m4REK/Projekt-B/Projekt B_Dokumentation.pdf

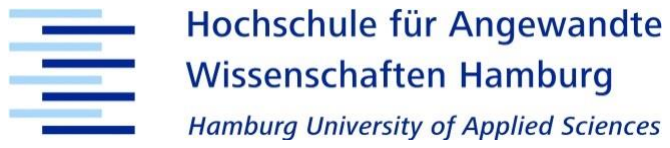
[picture p1: figure]

Fakultät Design, Medien, Information

Kunst- und Mediencampus Hamburg

Department Medientechnik

Studiengang Media Systems

Projekt:

## Arduino-Smart-Home

„Entwicklung und Konstruktion einer Steuerung für Funksteckdosen via Web-App“

Projektteilnehmer: Marko Vukadinovic, Sebastian Bohn, Johannes Bagge, Florian Langhorst

Projektleiter: Prof. Dr. Andreas Plaß, Dipl. Ing. Michael Berens

Projekt B | Arduino-Smart-Home

## Inhaltsverzeichnis

## 1 Projektbeschreibung

Das Ziel dieses Projekts ist es mit Hilfe einer Arduino Uno Entwicklungsplattform und einer

selbstentwickelten Webseite, eine oder mehrere Funksteckdosen ein- und ausschalten zu

können. Erweitert wird dies um eine Steuerung für den Betrieb einer

Pflanzenbewässerungsanlage.

## 2 Projektplanung

### 2.1 Definition der Projektumsetzung

Eine möglichst genaue Definition der zu realisierenden Ziele ist wichtig, um das Projekt

effektiv umzusetzen. Folgende Meilensteine wurden in der Planung definiert:

- Netzwerkkommunikation durch den Arduino
- Steuerung der Stromquellen durch den Arduino
- Webinterface für kabellose Kommunikation
- Ansteuern einer Pflanzenbewässerung

Vorab ist es ratsam sich im Internet über ähnliche Projekte zu informieren, um eine Liste der

benötigten Komponenten zu erstellen. Von Vorteil sind Grundkenntnisse der Elektrotechnik,

Elektronik, Netzwerktechnik und objektorientierten Programmierung. Es sollte auch

genügend Zeit für Testphasen eingeplant werden, um sich den sicheren Umgang mit den

einzelnen Elementen anzueignen. Eine gute Quelle für den Einstieg ist die Webseite

http://www.arduino.cc, auf der viele nützliche Tutorials und ein hilfreiches Forum zu finden

sind.

## 3 Hardware

### 3.1 Arduino Uno R3

Arduino Uno R3 ist ein Mikrocontroller Entwicklungsboard das auf dem ATmega328 basiert.

Dieser wird für sogenanntes „Prototyping“ genutzt, um zum Beispiel den Input von

verschiedenen Sensoren und Schaltern zu verarbeiten und über den Output Stromkreise,

Lichtquellen, Relais und Motoren zu kontrollieren.

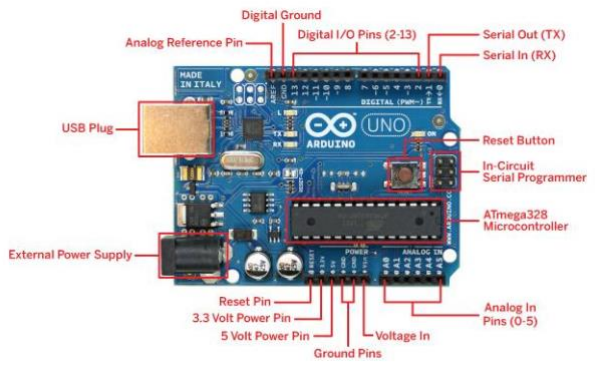
[picture p2: figure]

Datenblatt Arduino Uno R3
Mikrocontroller | ATmega328
Betriebsspannung | 5V
Eingangsspannung (empfohlen) | 7-12V
Eingangsspannung
(maximum) | 6-20V
Digitale I/O Pins | 14 (6 bieten PWM/Pulse-width modulation)
Analoge Input Pins | 6
DC pro I/O Pin | 40 mA
DC für 3.3V Pin | 50 mA
Flash Speicher | 32 KB (ATmega328), davon 0.5 KB für den
| Bootloader belegt
SRAM | 2 KB (ATmega328)
EEPROM | 1 KB (ATmega328)

Abbildung 1: Arduino Uno R3 und Erläuterung der Elemente

Clock Frequenz | 16 MHz
Kosten | ca. 22,00 €

### 3.2 Ethernet-Shield

Ein Shield ist eine Erweiterung des Boards, welches zusätzliche Schnittstellen für den

Mikrocontroller bietet. Mit dem Ethernet-Shield ist es möglich durch ein RJ45 LAN-Kabel

eine Netzwerkverbindung aufzubauen. Zusätzlich bietet dieser noch einen Steckplatz für

eine Mikro-SD Karte zur Auslagerung größerer Daten. Der Shield wird direkt auf den Arduino

aufgesteckt, so dass die Pins über das Shield zu erreichen sind. Jedoch werden für die einige

Funktionen mehrere Pins belegt. Zu Beginn wurde ein Nachbau des Originals verwendet,

welches jedoch Probleme mit der Stabilität der Stromversorgung bereitete. Daraufhin wurde

ein Original Arduino Ethernet-Shield nachgekauft und verwendet.

Datenblatt Arduino Ethernet-Shield
Betriebsspannung | 5V (über den Arduino)
Ethernet Controller | W5100 mit internem 16K Buffer
Verbindungsgeschwindigkeit | 10/100 Mb
Pin 4 | Mikro-SD Kartenslot
Pin 10-13 | W5100 und Netzwerkkommunikation
Bibliotheken | Ethernet.h; SD.h; SPI.h;...usw.
LEDs
PWR | Stromversorgung aktiv
LINK | leuchtet bei vorhandener
| Netzwerkverbindung; blinkt wenn das Shield
| Daten sendet oder empfängt
100M | bei einer 100 Mb/s Verbindung
RX | Daten werden empfangen
TX | Daten werden gesendet
FULLD | Netzwerkverbindung ist Vollduplex
COLL | blinkt bei Netzwerkkollisionen
Kosten Nachbau | ca. 8,00 €
Kosten Original | ca. 30,00 €

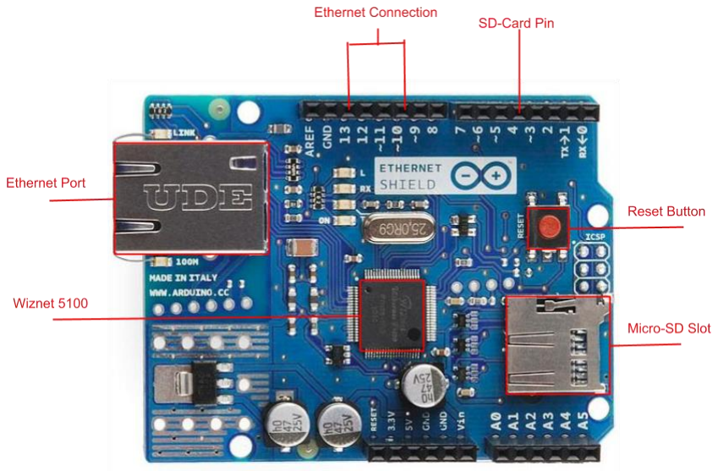
[picture p3: figure]

Abbildung 2 : Arduino Ethernet-Shield mit Erläuterung der Elemente

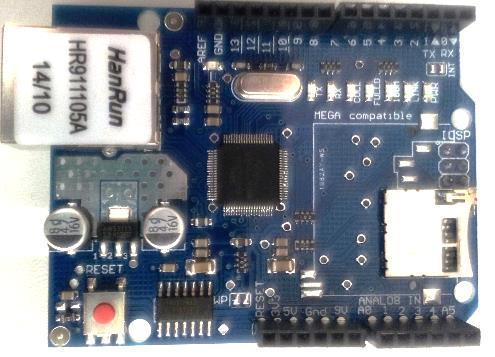
[picture p4: figure]

Abbildung 3: Ethernet-Shield Nachbau

### 3.3 Relais

Ein Relais ist ein durch elektrischen Strom betriebener Schalter, mit dem man andere

Stromkreise aktivieren oder deaktivieren kann. Für dieses Projekt wurden zwei 4-Kanal

Relais verwendet, welche einen Default-Zustand auf HIGH haben und auf LOW schalten.

Datenblatt Relais
Betriebsspannung über Arduino | 5V
Strom pro Kanal | 15 - 20mA

VCC | Integrated Circuit (IC) Stromversorgung
| (positiv)
GND | Ground
IN1-IN4 | Relais 1-4; je eine Verbindung zu einem I/O
| Pin
NC | Normally Closed; Ruhekontakt; Break
NO | Normally Open; Arbeitskontakt; Make
CO | Change Over; Wechselkontakt; Break-Make
Kosten pro Modul | ca 3,60 €

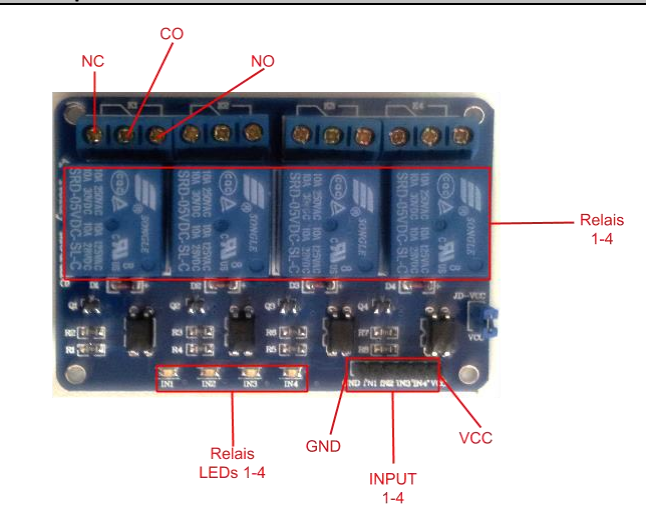
[picture p5: figure]

Abbildung 4: 5V 4-Kanal Relais mit Erläuterung der Elemente

### 3.4 Funksteckdosen mit Sender

Verwendet wurden handelsübliche 433 MHz Funksteckdosen mit vier Kanälen an der

Fernbedienung und drei Steckdosen (ohne Dip Schalter). Der Aufbau der Platine der

Fernbedienung unterscheidet sich je nach Hersteller.

Datenblatt Funksteckdosen-Set
Betriebsspannung Fernbedienung | 12V Batterie
Spannung Steckdosen | 230V / 50 Hz
maximale Schaltleistung | 1000 W
Reichweite | ca. 30 m
Frequenz | 433.92 MHz
Verwendetes Modell | Mumbi m-FS300

Kosten | ca. 17,00 €

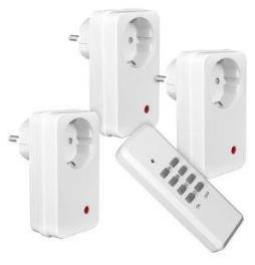
[picture p6: figure]

Abbildung 5: Funksteckdosen-Set von Mumbi

### 3.5 Verbrauchsmaterial, Kabel und Zusatzteile

- Schrumpfschlauch
- Lötplatinen
- Schrauben und Muttern
- Abstandshalter
- Jumper Kabel
- Kabel-Steckbrücken
- 8-poliges RJ-45 Netzwerkkabel
- 9V Netzteil
- Breadboard, LEDs, Widerstände (für Testaufbauten)

### 3.6 Werkzeug

- Schraubendreher
- Crimpzange
- Multimeter

- Heißklebepistole und Kleber
- Bohrmaschine

## 4 Software

Arduino bietet eine eigene, auf Java basierende, Open-Source Entwicklungsumgebung,

welche vorab schon viele Bibliotheken und Beispielprogramme enthält. Als

Programmiersprache wird Processing verwendet, welche an eine vereinfachte Variante von

C++ erinnert und objektorientiert ist.

Mit der Entwicklungsumgebung können Programme geschrieben, getestet, auf den

Mikrocontroller aufgespielt und während der Laufzeit debugged werden. Diese läuft auf

allen üblichen Systemen wie Windows, Mac OS X und Linux.

http://arduino.cc/en/Main/Software

## 5 Umsetzung

### 5.1 Analyse und Tests der Bauteile

Im ersten Schritt der Projektrealisierung, ist es von Vorteil sich mit den einzelnen

Komponenten und ihren Funktionen vertraut zu machen. Zum Einstieg kann man sich mit

einfachen Versuchsaufbauten einarbeiten. Hier können die verschiedenen Basic-

Beispielprogramme der Entwicklungsumgebung helfen. Ein Beispielaufbau wäre, eine

einfache LED über den Arduino und ein Relais zum leuchten zu bringen. Dafür ist es nötig

sich mit grundlegenden Regeln der Elektrotechnik auseinanderzusetzen, wie Stromstärke,

Spannung, Widerständen und Flussrichtung. Das Programm oder Sketch wie es in der

Entwicklungsumgebung heißt, bestimmt die Pins (Aus-/Eingänge) und was dort passieren

soll. Dieser kann aus einem oder mehreren Tabs bestehen, wodurch objektorientierter Code

möglich ist. Dieser darf beim Uno jedoch maximal 32 KB groß sein. Wenn das Programm erfolgreich auf den Arduino geladen wurde, läuft dieses in einer Endlosschleife, solange die

Stromzufuhr aktiv ist. Die Kabelverbindungen können alle mit simplen Jumper Wires

(Kabelbrücken) verdrahtet werden. Bei den Tests der Relais, kann es sein das die

Stromzufuhr über das USB-Kabel des Computers nicht ausreicht und ein instabiles oder gar

kein Signal bei den Relais ankommt. Hierfür ist ein zusätzliches Netzteil von Vorteil.

Der nächste Schritt ist die Analyse der Funkfernbedienung des Steckdosen-Sets. Diese

können je nach Hersteller variieren. In diesem Fall besteht die Platine aus acht

Kontaktpunkten (vier ON; vier OFF), drei Kontaktbrücken, in denen bestimmte Kontakte

zusammenlaufen, und einem Logik-Gatter. Die acht Kontaktpunkte sind jeweils gespalten

und das Auslösen des jeweiligen Funksignals erfolgt durch Überbrückung des Kontakts. Nun

testet man, welche Kombinationen aus Punkten und Brücken welches Signal auslösen und

schreibt das Ergebnis in eine Tabelle. Aus dieser Tabelle ermittelt man die kleinstmögliche

Anzahl der benötigten Lötpunkte.

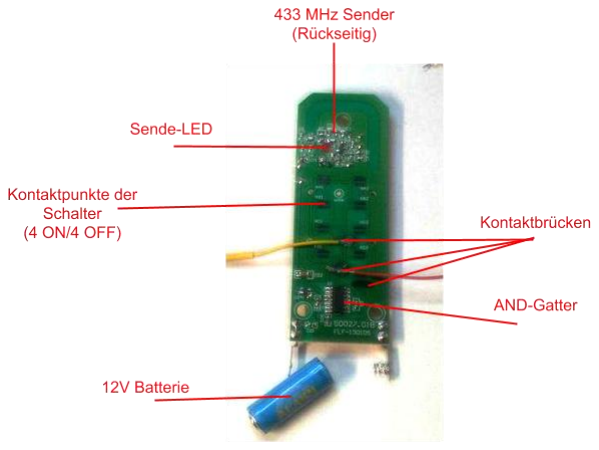
[picture p7: figure]

Abbildung 6: Platine der Funkfernbedienung und Erläuterung der Elemente

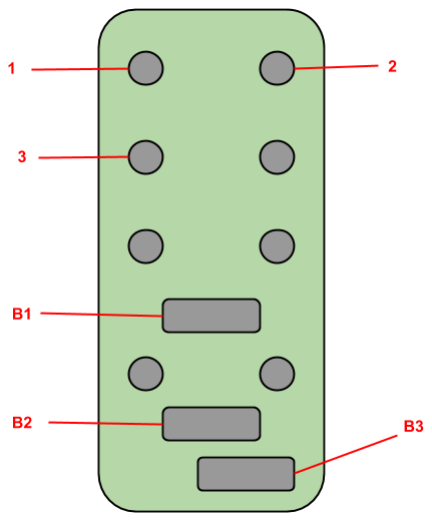
[picture p8: figure]

Abbildung 7: Deklaration der gewählten Kontakte

Schalter | AND-Verknüpfung von Kontakt A und Kontakt B
A ON | 2 | 1
A OFF | 2 | B3
B ON | 2 | 3
B OFF | 2 | B2
C ON | B1 | 1
C OFF | B1 | B3
D ON | B1 | 3
DOFF | B1 | B2

### 5.2 Verkabelung der Sende-Platine

Für das verkabeln der gewählten Punkte ist löten leider nicht immer möglich, da Lötzinn auf

dieser Art Platinen nicht haftet. Eine Alternative ist Heißkleber, welcher nach anpressen

genügend halt gibt, aber sich auch rückstandsfrei lösen lässt.

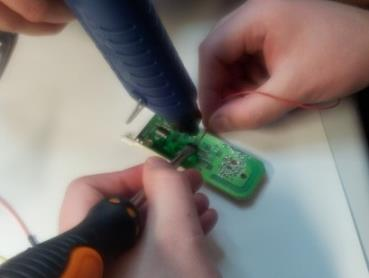
[picture p9: figure]

Abbildung 8: Verbindung der Kabel mit Heißkleber auf den Kontakten

Mit Hilfe der erstellten Schalttabelle, können die minimal benötigten Kontaktpunkte

ermittelt werden und entsprechend viele Abzweigungen des Kabels vorgenommen werden.

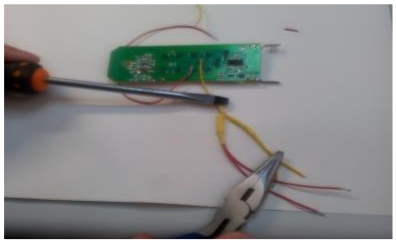
[picture p10: figure]

Abbildung 9: Verzweigungen der Kabel für einzelne Kontakte

Farbige Kabel können zur Übersicht beitragen. Um die Abzweigungen zu isolieren und

festigen, sollte Schrumpfschlauch verwendet werden.

Um die Platine und die Klebepunkte vor äußeren Einwirkungen zu schützen, kann die

Plastikhülle weitervervendet werden. Dabei reicht ein seitlich eingefräster Schlitz als

Durchlass und Zugentlasstung.

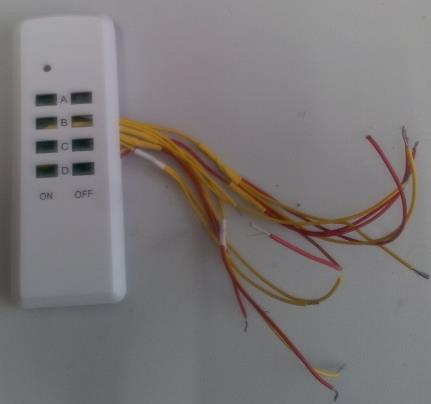
[picture p11: figure]

Abbildung 10: Funkfernbedienung mit fertiger Verkabelung

### 5.3 Verbindung von Arduino, Relais und Sender

Als nächstes wird das Auslösen eines Funksignals über ein Relais getestet. Ein kurzer Impuls

reicht dem Schalter in der Regel aus. Dieser liegt in etwa bei 500 ms, da bei zu kurzen

Impulsen der Empfänger nicht immer ein Signal empfängt. Ein Pin ist mit einem Relais, für

einen Schalter zuständig.

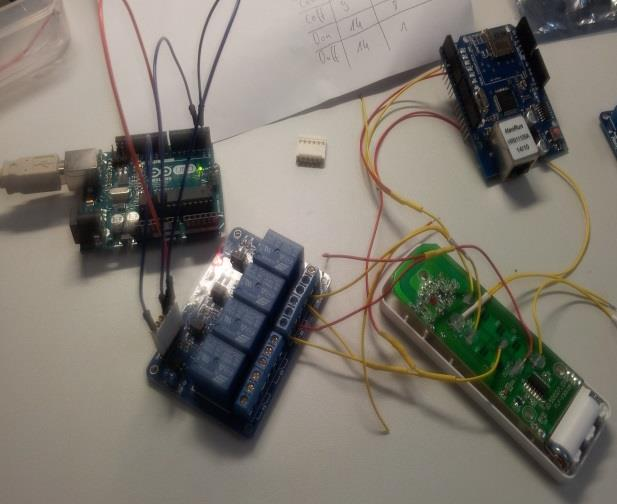
[picture p12: figure]

Abbildung 11: Testen der Steuerung des Senders über den Arduino und Relais

Um alle Schalter anzusteuern, benötigt man also acht freie I/O Pins und acht Relais. Da in

einem Set aber nur drei Steckdosen enthalten sind, reichen sechs Pins und Relais aus.

Entsprechend kann man einen ON und zugehörigen OFF Schalter frei lassen und diesen

isolieren. Es sollte ebenfalls bedacht werden, das Pin 10 – 13 für den Ethernet-Shield und Pin

4 für die Mikro-SD Karte (wenn benötigt) reserviert sind. Um beide Relais-Module zu nutzen,

muss vom Arduino ausgehend eine Parallelschaltung zu den beiden Relais gelegt werden.

Dies erreicht man mit der Splittung des 5V und GND Aus-/Eingangs. Unterstützend ist hier

ein Netzteil anzuraten, um die Stromzufuhr der Relais zu stabilisieren.

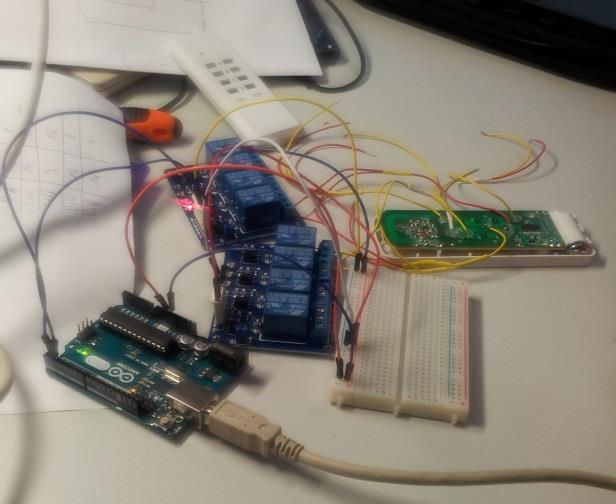
[picture p13: figure]

Abbildung 12: Test mit beiden Relais-Modulen

Wenn alle Relais zufriedenstellend schalten, kann die Anordnung der Bauteile für eine

kompakte Fixierung geplant werden. Um die Kabelwege nicht unnötig lang zu gestalten und

die Fläche klein zu halten, empfiehlt es sich auf zwei oder mehreren Ebenen zu arbeiten.

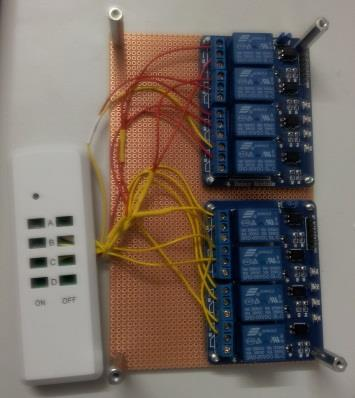
[picture p14: figure]

Abbildung 13: Relais auf einer Lötplatte

In diesem Beispiel werden zwei Ebenen verwendet. Als Platte können Leiterplatinen dienen,

welche durch aufgebohrte Löcher verschraubt werden. Auf der unteren Platine sind die

beiden Relais-Module und die Fernbedienung angeordnet. Das Batteriefach der

Fernbedienung sollte allerdings noch einfach zu erreichen sein.

Auf der oberen Platine sind Arduino Uno und Ethernet-Shield aufeinander gesteckt und

verschraubt. Die Position sollte auch idealerweise am Rand der Platine, mit den Anschlüssen

für Ethernet, Strom und USB nach außen sein. Das ermöglicht den vereinfachten Zugang der

Anschlüsse, falls die Konstruktion in eine Box gesetzt werden soll.

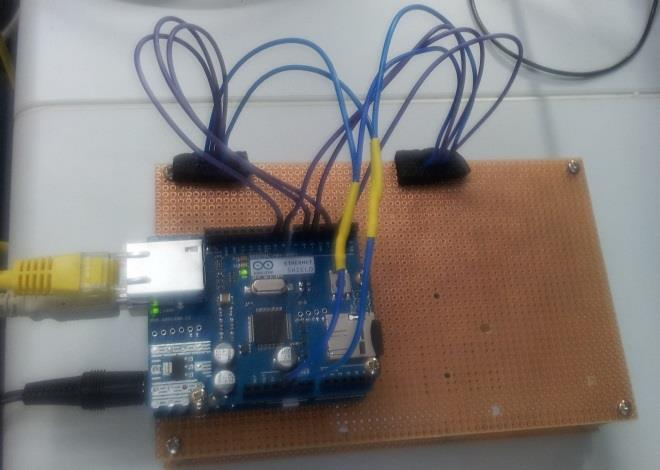
[picture p15: figure]

Abbildung 14: Oberer Teil des Zusammenbaus mit Arduino und Shield

## 6 Programmierung

Das Programm mit dem Webserver, den Webseiten und der Pin-Steuerung besteht aus einer

Klasse.

Einbinden der benötigten Bibliotheken, die der Shield-

Erweiterung und der Netzwerkkommunikation.

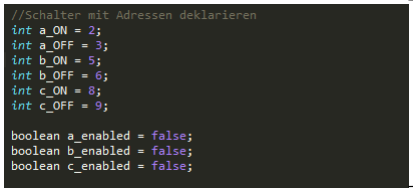
[picture p16: figure]

Setzen der Variablen, welche mit den

gewählten Pins übereinstimmen müssen.

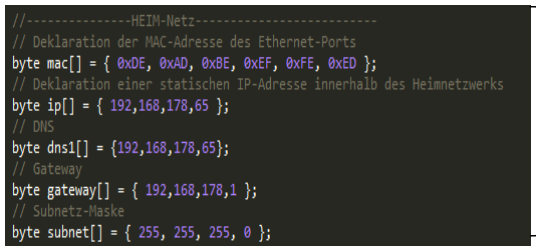
[picture p17: figure]

Deklaration einer statischen,

selbstgewählten MAC-Adresse. IP-Adresse,

DNS, Gateway und Subnetz muss nur selbst

vergeben werden wenn DHCP nicht

genutzt wird.

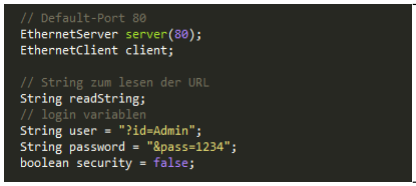
[picture p18: figure]

Variablen für den Server, das Speichern der

Zeichen in der URL, sowie für den Login

(hier inkl. Präfixe) werden deklariert.

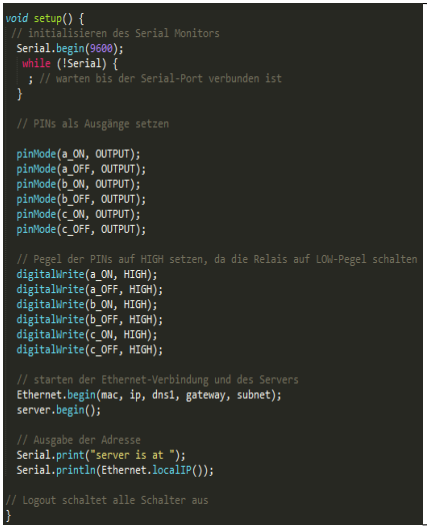
[picture p19: figure]

Die „setup()“-Methode wartet

zunächst solange bis der Serial-Port

verbunden ist.

Danach werden die Pins für die drei

Funksteckdosen als Ausgänge

festgelegt und ihre Pegel

standardmäßig auf High gesetzt.

Nun werden die Ethernetverbindung

und der Server gestartet. Die Adresse

wird im Serial Monitor ausgegeben.

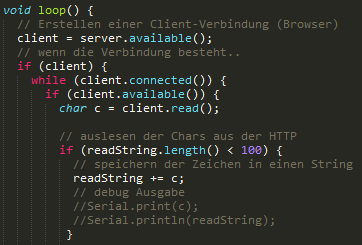
[picture p20: figure]

In der loop()-Methode wird zunächst eine

Clientverbindung (Browser) aufgebaut, welche so

lange wartet, bis ein Client verbunden ist.

Danach werden die Zeichen aus der URL

ausgelesen und in einer String-Variablen

gespeichert.

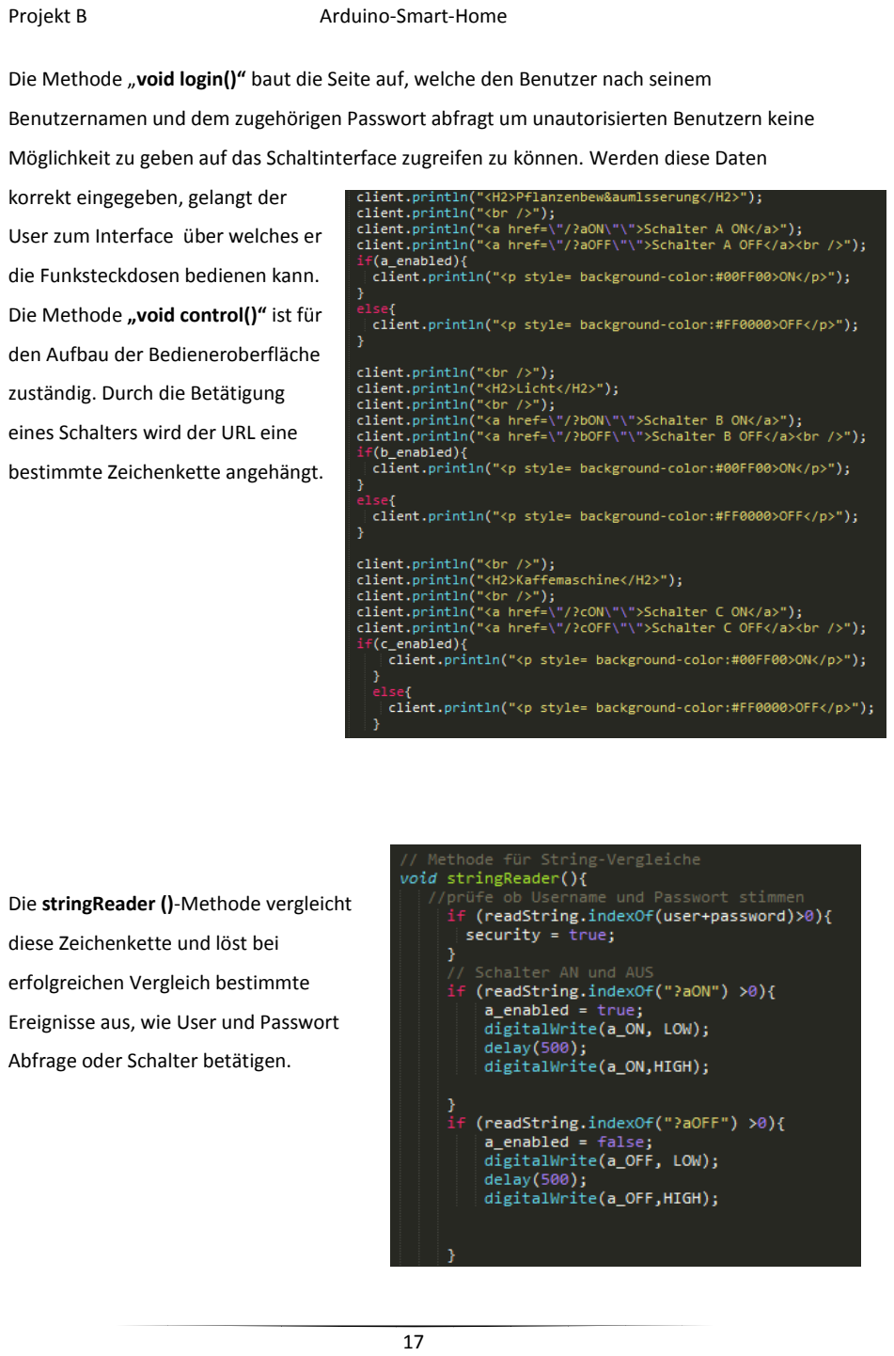
[picture p21: page 18]

Die Methode „void login()“ baut die Seite auf, welche den Benutzer nach seinem

Benutzernamen und dem zugehörigen Passwort abfragt um unautorisierten Benutzern keine

Möglichkeit zu geben auf das Schaltinterface zugreifen zu können. Werden diese Daten

korrekt eingegeben, gelangt der

User zum Interface über welches er

die Funksteckdosen bedienen kann.

Die Methode „void control()“ ist für

den Aufbau der Bedieneroberfläche

zuständig. Durch die Betätigung

eines Schalters wird der URL eine

bestimmte Zeichenkette angehängt.

Die stringReader ()-Methode vergleicht

diese Zeichenkette und löst bei

erfolgreichen Vergleich bestimmte

Ereignisse aus, wie User und Passwort

Abfrage oder Schalter betätigen.

## 7 Programmierung der Steckdosen

Um den Funksteckdosen einen bestimmten Kanal/Schalter zuzuweisen, muss man

entsprechend vorgehen:

1. Eine einzelne Steckdose einstecken.
2. Einen Schalter im Interface anklicken.
3. Steckdose ist nun über diesen Schalter anwählbar.

Für die übrigen Steckdosen Schritte 1. – 3. wiederholen.

Um den Kanal/Schalter einer Funksteckdose wieder zu löschen, muss man entsprechend

vorgehen:

1. Falls die gewählte Steckdose aktiviert ist, diese ausschalten.
2. Die Steckdose herausziehen.
3. Die Steckdose wieder einstecken.
4. Während die Steckdose blinkt, nochmals ausschalten und warten bis das LED nicht mehr

blinkt.

Um die Steckdose neu zuzuweisen, wie oben beschrieben vorgehen.

## 8 Weiterentwicklungsmöglichkeiten

Während der Entwicklung und Arbeit an diesem Projekt wurden die Möglichkeiten, aber

auch die entstandenen Grenzen klar. Für die Erweiterung auf mehr als vier Steckdosen,

könnten verschiedene Strategien in Betracht gezogen werden. Der Arduino Uno ist mit

seinen vorhandenen Pins begrenzt und kann mit diesem Projekt nicht mehr als vier

Funkkanäle ansteuern. Ein Wechsel auf ein größeres Entwicklungsboard wäre eine Variante

zum Ausbau der Ausgänge. Die Nutzung eigener 433 MHz Sender und Empfänger als Bauteil

und programmierbare Funksteckdosen mit Dip-Schalter, würde die Erstellung eigener Kanäle

ermöglichen.

Ein Wechsel auf ein anderes Entwicklungsboard mit eigenem Betriebssystem und

integrierter Schnittstelle für LAN oder WiFi könnte Kosten sparen und würde die Nutzung zusätzlicher Software ermöglichen. Somit wäre der Gebrauch einer Datenbank einfacher und

könnte für mehr Sicherheit der Steuerung liefern.

Der Arduino selbst beherrscht leider kein Multi-Processing wie Threads, kann aber mit

Bibliotheken ersetzt werden.

Die Integration von verschiedenen Open-Source Bibliotheken wie Arduino.js, etc. und die

Auslagerung von Speicher erweitert das Potential von Mikrocontrollern.

Servomotoren, Sensoren oder eine Webcam wären gute Verbesserungen für die

Bewässerungsanlage. Somit könnten die Kontrollen und Sicherheitsmechanismen ausgebaut

werden.

## 9 Kosten

In der Kostenauflistung sind nur die grundlegenden Komponenten aufgelistet, nicht jedoch

Werkzeug, Test- und Verbrauchsmaterial.

Teile | Kosten
Arduino Uno | 22,00
Arduino Ethernet-Shield | 30,00
Relais | 7,20
Funksteckdosen-Set | 17,00
Gesamtsumme | ca. 76,20 €

## 10 Zeitmanagement und Aufgabenverteilung

Personen | Planung | Materialbeschaffung | Einarbeitung
Sebastian Bohn | 10 | 8 | 10
Florian Langhorst | 10 | | 10
Marko Vukadinovic | 10 | 8 | 10

Johannes Bagge | 10 | 10
Personen | Entwicklung | Testphase und Fehlerbeseitigung | Dokumentation
Sebastian Bohn | 18,5 | 18,5 | 12
Florian Langhorst | 17 | 17 | 12
Marko Vukadinovic | 10 | 10
Johannes Bagge | 8 | 8
Gesamtaufwand in Stunden | ca. 227 Std.

## 11 Fazit

Mit diesem Projekt wird aufgezeigt, das man mit wenigen Mitteln und geringen

Vorkenntnissen, eine simple Heimautomation bauen kann. Das hierbei erworbene Wissen

stellt eine gute Basis für mögliche Erweiterungen, Verbesserungen und weitere Projekte im

Bereich „Prototyping“ dar. Durch eine riesige Variation an Bauteilen und einem großen

freien Softwareangebot, sind den Ideen und ihren Umsetzungen nur wenige Grenzen

gesetzt.

Der Source-Code ist unter dem Repository https://github.com/m4REK/Projekt-B zugänglich.

## Abbildungsverzeichnis
