m4REK/Projekt-B/(commit log)

2014-05-09 Kostenkalkulation und Projektplan für PROJEKT-B hinzugefügt
2014-11-08 WebSteuerung ver. 1.0
    +Login and Security
    +Switch Control
    +Style Changes
    +Logout and Security
2014-11-19 bugfixes und Doku korrigiert
    +Dummy Daten für Netzwerk
    +Shutdown-Methode gefixt
    +Projektdokumentation korrigiert
    [WebSteuerung_Arduino_ver_1.0.ino]
